plexon-dev3/AIR-QUALITY-PROJECTS/AIR QUALITY LEDS/AIR QUALITY LEDS.kicad_pcb

## KiCad design AIR QUALITY LEDS/AIR QUALITY LEDS.kicad_pcb (2026-05-13)

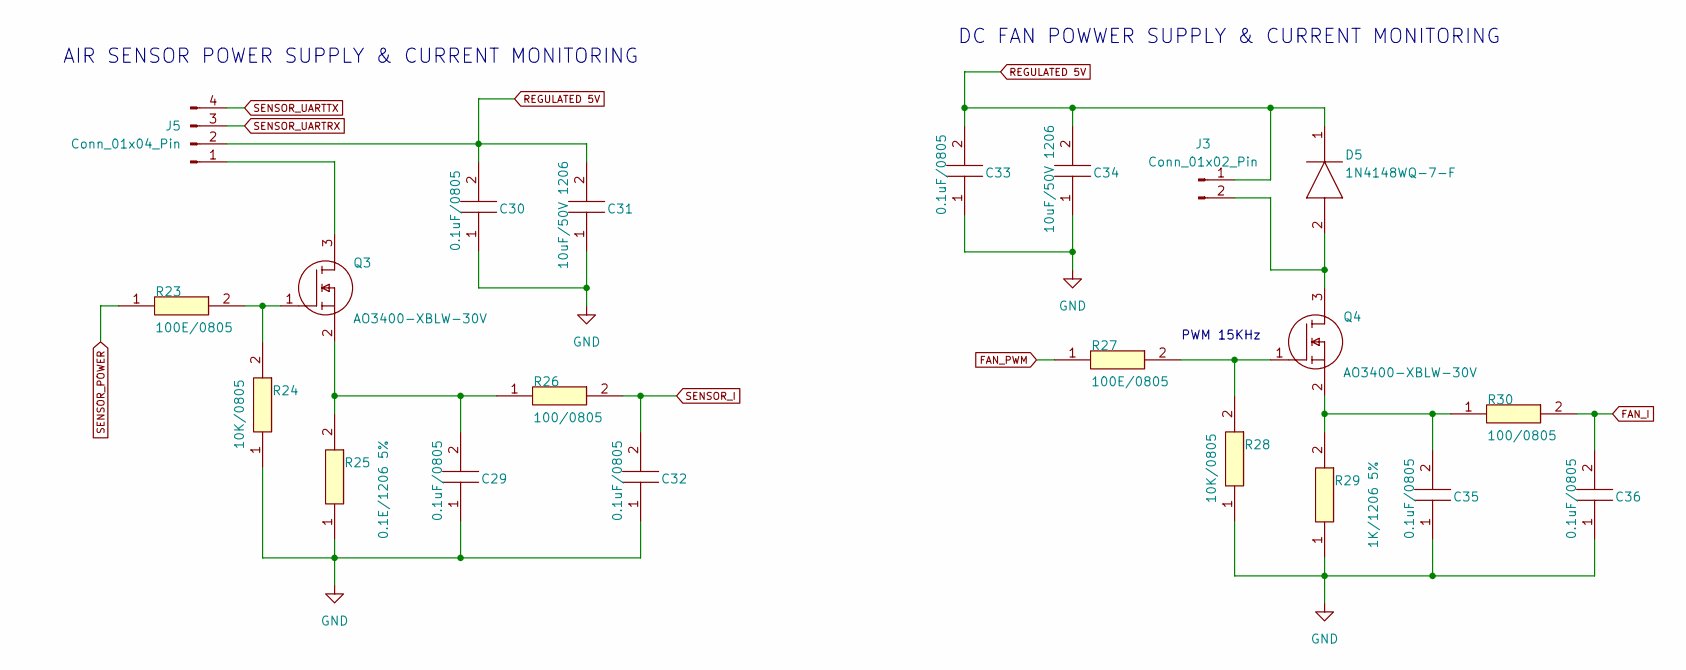
[picture p1: schematic SENSOR+FAN.kicad_sch]

Parts:
C29, C30, C32, C33, C35, C36: 0.1uF/0805; C_0805_2012Metric; MANUFACTURER_PART_NUMBER C0805C100F1GACAUTO
C31, C34: 10uF/50V 1206; C_1206_3216Metric; MANUFACTURER_PART_NUMBER C1206C221F5GACAUTO; MOUSER PART NUMBER 80-C1206C221F5GAUTO
D5: 1N4148WQ-7-F; SOD3716X145N; MANUFACTURER_PART_NUMBER 1N4148WQ-7-F; MOUSER PART NUMBER 621-1N4148WQ-7-F
J3: Conn_01x02_Pin; PinSocket_1x02_P2.54mm_Vertical
J5: Conn_01x04_Pin; Hirose_DF13-04P-1.25DSA_1x04_P1.25mm_Vertical
Q3, Q4: AO3400-XBLW-30V; SOT95P237X112-3N; MANUFACTURER_PART_NUMBER IRLML6344TRPBF; MOUSER PART NUMBER 942-IRLML6344TRPBF
R23, R27: 100E/0805; R_0805_2012Metric; MANUFACTURER_PART_NUMBER CMP0805QFX-1001ELF; MOUSER PART NUMBER 652-CMP0805QFX-1001E
R24, R28: 10K/0805; R_0805_2012Metric; MANUFACTURER_PART_NUMBER CMP0805QFX-1001ELF; MOUSER PART NUMBER 652-CMP0805QFX-1001E
R25: 0.1E/1206 5%; R_1206_3216Metric; MANUFACTURER_PART_NUMBER CR1206-FX-16R2ELF; MOUSER PART NUMBER 652-CR1206FX-16R2ELF
R26, R30: 100/0805; R_0805_2012Metric; MANUFACTURER_PART_NUMBER CMP0805QFX-1001ELF; MOUSER PART NUMBER 652-CMP0805QFX-1001E
R29: 1K/1206 5%; R_1206_3216Metric; MANUFACTURER_PART_NUMBER CR1206-FX-16R2ELF; MOUSER PART NUMBER 652-CR1206FX-16R2ELF

Connections:
FAN_I: C36.2, R30.2; also elsewhere on the board
FAN_PWM: R27.1; also elsewhere on the board
GND: C29.1, C30.1, C31.1, C32.1, C33.1, C34.1, C35.1, C36.1, R24.1, R25.1, R28.1, R29.1; also elsewhere on the board
unnamed: D5.2 (A), J3.2, Q4.3 (D)
unnamed: J5.1, Q3.3 (D)
unnamed: Q3.1 (G), R23.2, R24.2
unnamed: C29.2, Q3.2 (S), R25.2, R26.1
unnamed: Q4.1 (G), R27.2, R28.2
unnamed: C35.2, Q4.2 (S), R29.2, R30.1
REGULATED 5V: C30.2, C31.2, C33.2, C34.2, D5.1 (K), J3.1, J5.2; also elsewhere on the board
SENSOR_I: C32.2, R26.2; also elsewhere on the board
SENSOR_POWER: R23.1; also elsewhere on the board
SENSOR_UARTRX: J5.3; also elsewhere on the board
SENSOR_UARTTX: J5.4; also elsewhere on the board

Notes on the sheet:
AIR SENSOR POWER SUPPLY & CURRENT MONITORING
DC FAN POWWER SUPPLY & CURRENT MONITORING
PWM 15KHz

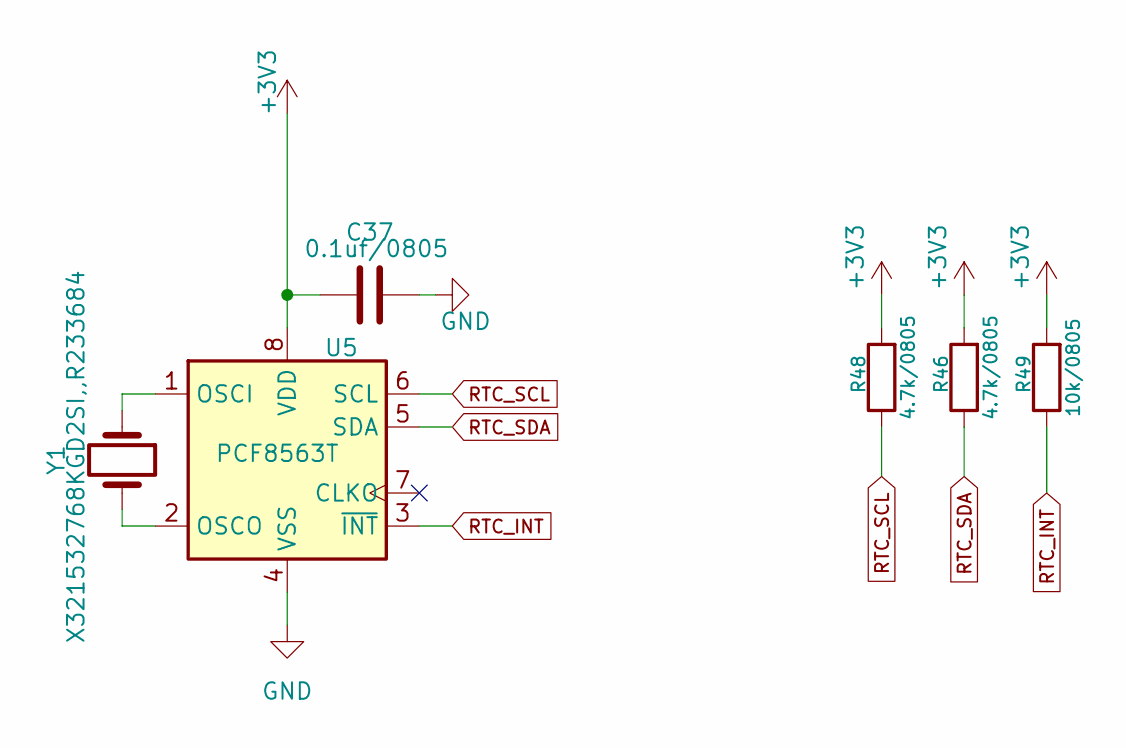
[picture p2: schematic RTC.kicad_sch]

Parts:
C37: 0.1uf/0805; C_0805_2012Metric
R46, R48: 4.7k/0805; R_0805_2012Metric
R49: 10k/0805; R_0805_2012Metric
U5: PCF8563T; SO-8_3.9x4.9mm_P1.27mm
Y1: X321532768KGD2SI,,R233684; Crystal_SMD_MicroCrystal_CC7V-T1A-2Pin_3.2x1.5mm

Connections:
+3V3: C37.1, R46.2, R48.2, R49.2, U5.8 (VDD); also elsewhere on the board
GND: C37.2, U5.4 (VSS); also elsewhere on the board
unnamed: U5.1 (OSCI), Y1.1
unnamed: U5.2 (OSCO), Y1.2
RTC_INT: R49.1, U5.3 (~INT); also elsewhere on the board
RTC_SCL: R48.1, U5.6 (SCL); also elsewhere on the board
RTC_SDA: R46.1, U5.5 (SDA); also elsewhere on the board

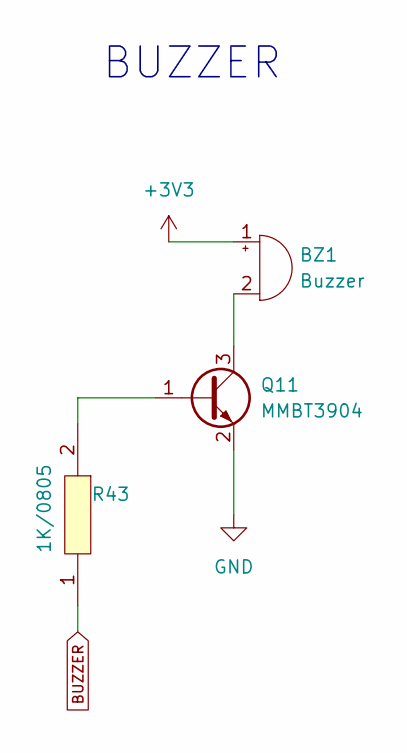
[picture p3: schematic BUZZER.kicad_sch]

Parts:
BZ1: Buzzer; Buzzer_12x9.5RM7.6
Q11: MMBT3904; SOT-23
R43: 1K/0805; R_0805_2012Metric; MANUFACTURER_PART_NUMBER CMP0805QFX-1001ELF; MOUSER PART NUMBER 652-CMP0805QFX-1001E

Connections:
+3V3: BZ1.1 (+); also elsewhere on the board
BUZZER: R43.1; also elsewhere on the board
GND: Q11.2 (E); also elsewhere on the board
unnamed: BZ1.2 (-), Q11.3 (C)
unnamed: Q11.1 (B), R43.2

Notes on the sheet:
BUZZER

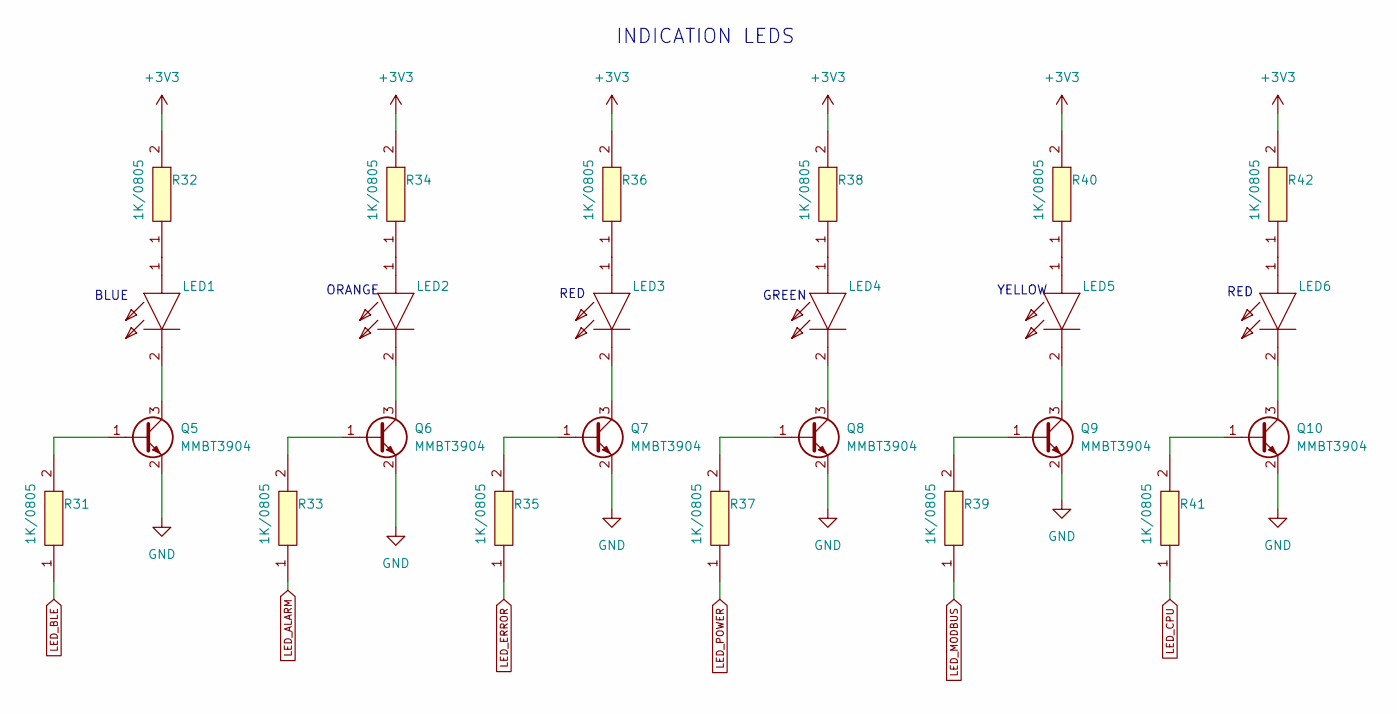
[picture p4: schematic INDICATION_LEDS.kicad_sch]

Parts:
LED1, LED2, LED3, LED4, LED5, LED6: LED_D5.0mm; MANUFACTURER_PART_NUMBER 151051BS04000; MOUSER PART NUMBER 710-151051BS04000
Q5, Q6, Q7, Q8, Q9, Q10: MMBT3904; SOT-23
R31, R32, R33, R34, R35, R36, R37, R38, R39, R40, R41, R42: 1K/0805; R_0805_2012Metric; MANUFACTURER_PART_NUMBER CMP0805QFX-1001ELF; MOUSER PART NUMBER 652-CMP0805QFX-1001E

Connections:
+3V3: R32.2, R34.2, R36.2, R38.2, R40.2, R42.2; also elsewhere on the board
GND: Q5.2 (E), Q6.2 (E), Q7.2 (E), Q8.2 (E), Q9.2 (E), Q10.2 (E); also elsewhere on the board
LED_ALARM: R33.1; also elsewhere on the board
LED_BLE: R31.1; also elsewhere on the board
LED_CPU: R41.1; also elsewhere on the board
LED_ERROR: R35.1; also elsewhere on the board
LED_MODBUS: R39.1; also elsewhere on the board
LED_POWER: R37.1; also elsewhere on the board
unnamed: LED1.1 (A), R32.1
unnamed: LED1.2 (K), Q5.3 (C)
unnamed: LED2.1 (A), R34.1
unnamed: LED2.2 (K), Q6.3 (C)
unnamed: LED3.1 (A), R36.1
unnamed: LED3.2 (K), Q7.3 (C)
unnamed: LED4.1 (A), R38.1
unnamed: LED4.2 (K), Q8.3 (C)
unnamed: LED5.1 (A), R40.1
unnamed: LED5.2 (K), Q9.3 (C)
unnamed: LED6.1 (A), R42.1
unnamed: LED6.2 (K), Q10.3 (C)
unnamed: Q5.1 (B), R31.2
unnamed: Q6.1 (B), R33.2
unnamed: Q7.1 (B), R35.2
unnamed: Q8.1 (B), R37.2
unnamed: Q9.1 (B), R39.2
unnamed: Q10.1 (B), R41.2

Notes on the sheet:
BLUE
RED
ORANGE
YELLOW
GREEN
INDICATION LEDS

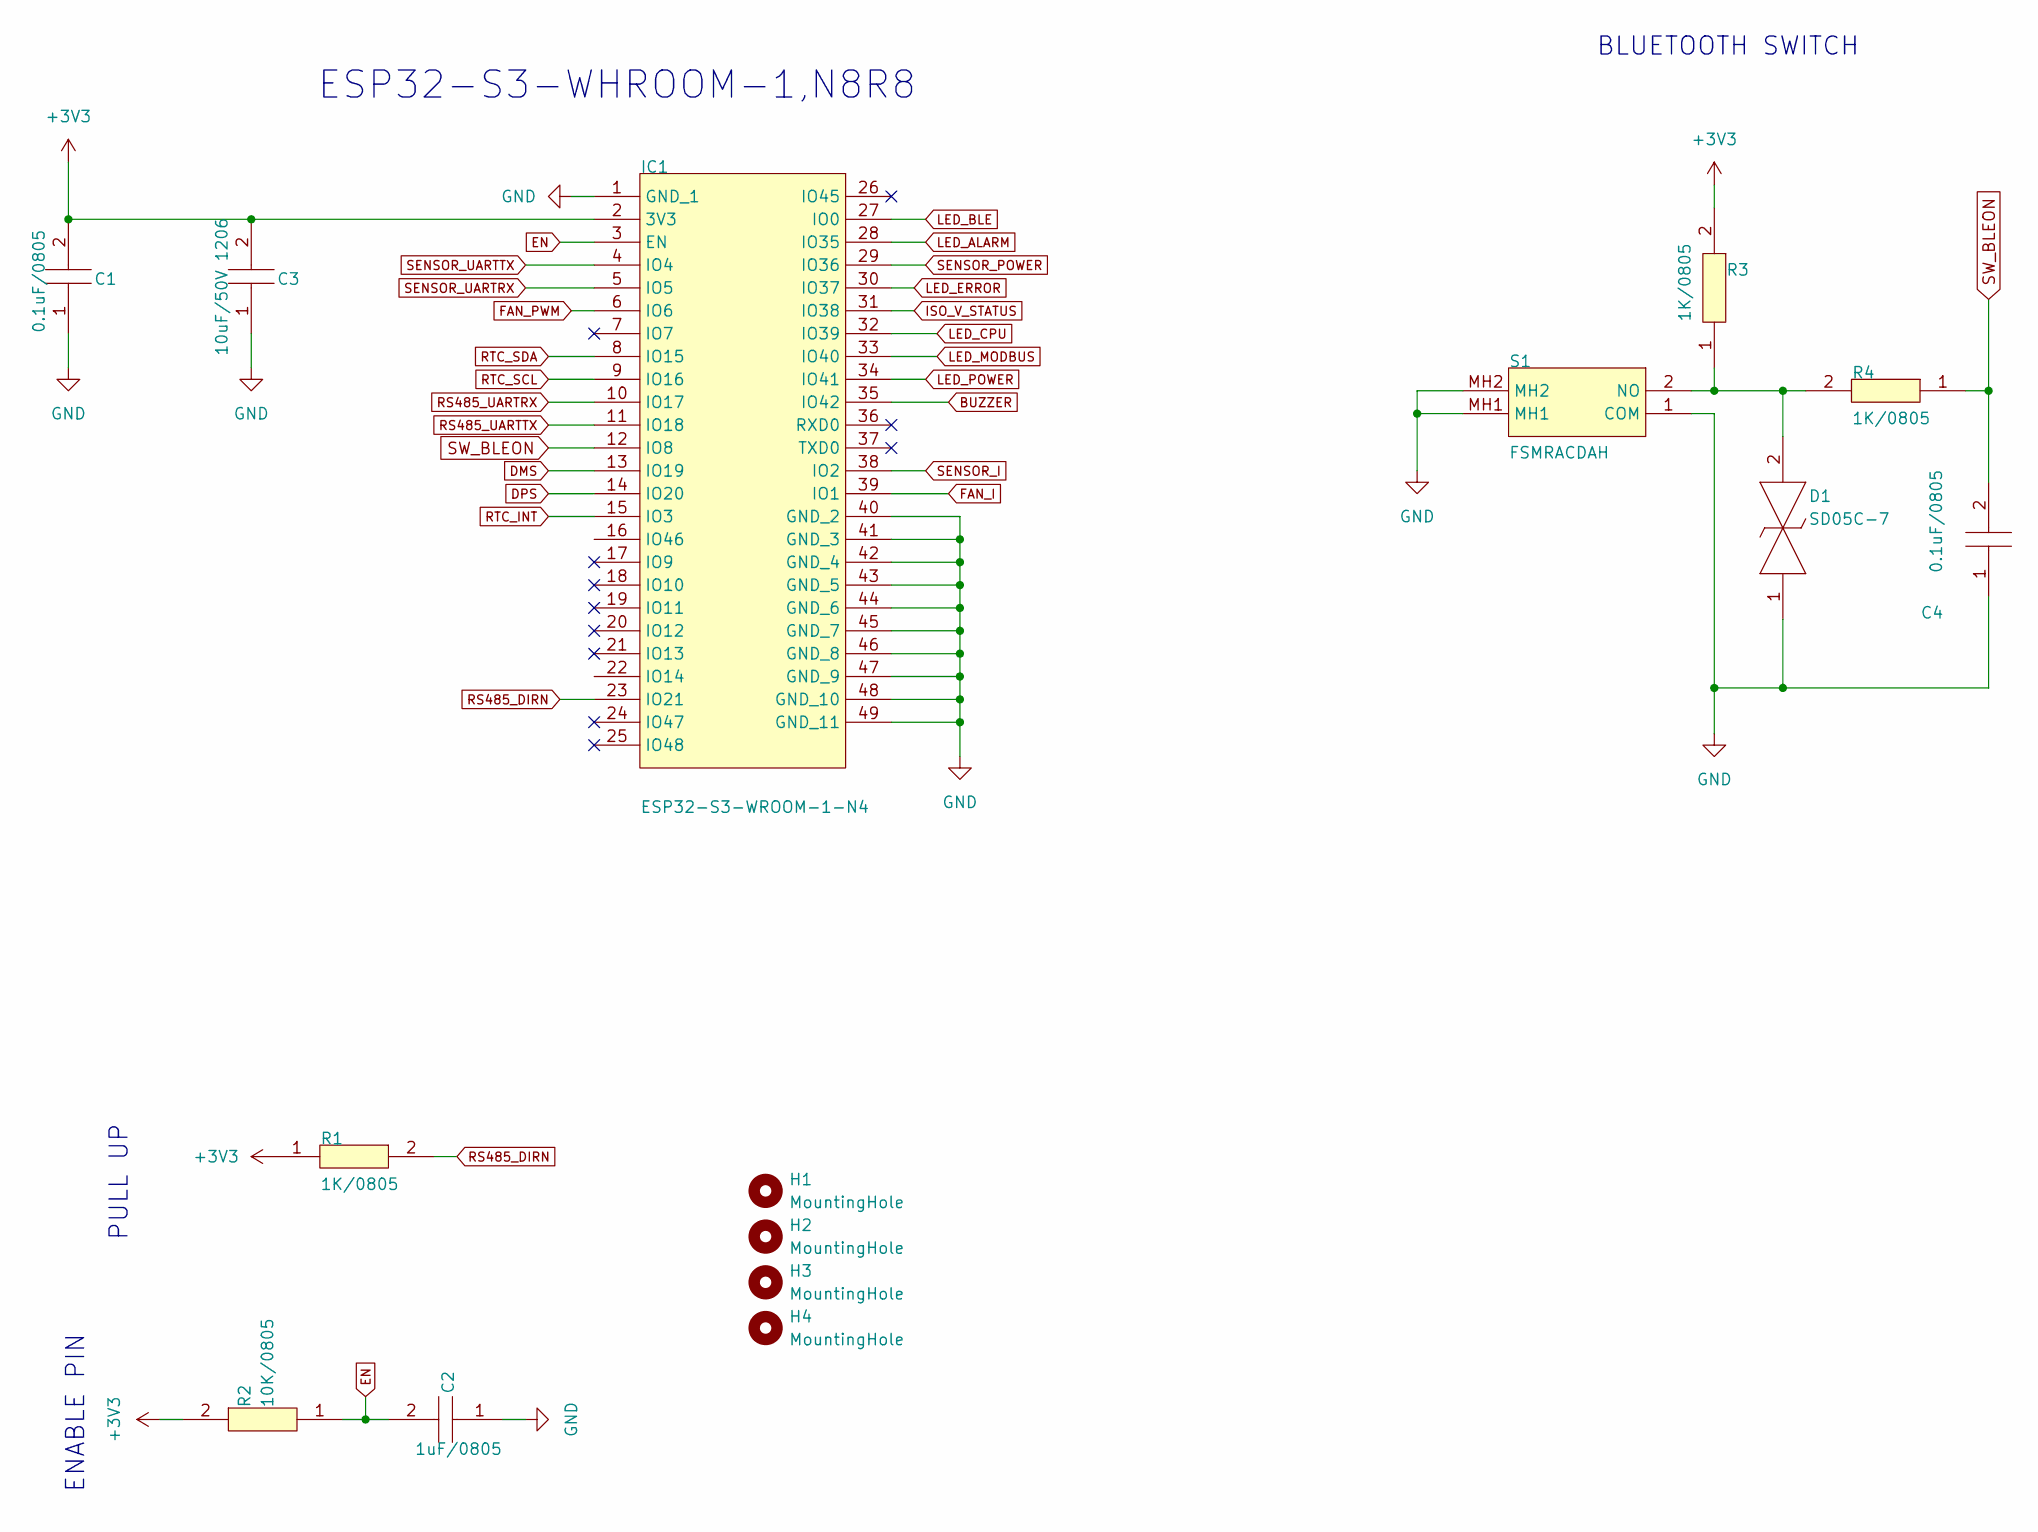
[picture p5: schematic ESP32-S3 MODULE.kicad_sch]

Parts:
C1, C4: 0.1uF/0805; C_0805_2012Metric; MANUFACTURER_PART_NUMBER C0805C100F1GACAUTO
C2: 1uF/0805; C_0805_2012Metric; MANUFACTURER_PART_NUMBER C0805C100F1GACAUTO
C3: 10uF/50V 1206; C_1206_3216Metric; MANUFACTURER_PART_NUMBER C1206C221F5GACAUTO; MOUSER PART NUMBER 80-C1206C221F5GAUTO
D1: SD05C-7; SOD2513X120N; MANUFACTURER_PART_NUMBER SD05C-7; MOUSER PART NUMBER 621-SD05C-7
H1, H2, H3, H4: MountingHole; MountingHole_3mm
IC1: ESP32-S3-WROOM-1-N4; ESP32S3WROOM1N8R8; MANUFACTURER_PART_NUMBER ESP32-S3-WROOM-1-N4; MOUSER PART NUMBER 356-ESP32-S3WROOM1N4
R1, R3, R4: 1K/0805; R_0805_2012Metric; MANUFACTURER_PART_NUMBER CMP0805QFX-1001ELF; MOUSER PART NUMBER 652-CMP0805QFX-1001E
R2: 10K/0805; R_0805_2012Metric; MANUFACTURER_PART_NUMBER CMP0805QFX-1001ELF; MOUSER PART NUMBER 652-CMP0805QFX-1001E
S1: FSMRACDAH; MANUFACTURER_PART_NUMBER FSMRACDAH; MOUSER PART NUMBER 506-FSMRACDAH

Connections:
+3V3: C1.2, C3.2, IC1.2 (3V3), R1.1, R2.2, R3.2; also elsewhere on the board
BUZZER: IC1.35 (IO42); also elsewhere on the board
DMS: IC1.13 (IO19); also elsewhere on the board
DPS: IC1.14 (IO20); also elsewhere on the board
EN: C2.2, IC1.3 (EN), R2.1
FAN_I: IC1.39 (IO1); also elsewhere on the board
FAN_PWM: IC1.6 (IO6); also elsewhere on the board
GND: C1.1, C2.1, C3.1, C4.1, D1.1, IC1.1 (GND_1), IC1.40 (GND_2), IC1.41 (GND_3), IC1.42 (GND_4), IC1.43 (GND_5), IC1.44 (GND_6), IC1.45 (GND_7), IC1.46 (GND_8), IC1.47 (GND_9), IC1.48 (GND_10), IC1.49 (GND_11), S1.1 (COM), S1.MH1, S1.MH2; also elsewhere on the board
ISO_V_STATUS: IC1.31 (IO38); also elsewhere on the board
LED_ALARM: IC1.28 (IO35); also elsewhere on the board
LED_BLE: IC1.27 (IO0); also elsewhere on the board
LED_CPU: IC1.32 (IO39); also elsewhere on the board
LED_ERROR: IC1.30 (IO37); also elsewhere on the board
LED_MODBUS: IC1.33 (IO40); also elsewhere on the board
LED_POWER: IC1.34 (IO41); also elsewhere on the board
unnamed: D1.2, R3.1, R4.2, S1.2 (NO)
RS485_DIRN: IC1.23 (IO21), R1.2; also elsewhere on the board
RS485_UARTRX: IC1.10 (IO17); also elsewhere on the board
RS485_UARTTX: IC1.11 (IO18); also elsewhere on the board
RTC_INT: IC1.15 (IO3); also elsewhere on the board
RTC_SCL: IC1.9 (IO16); also elsewhere on the board
RTC_SDA: IC1.8 (IO15); also elsewhere on the board
SENSOR_I: IC1.38 (IO2); also elsewhere on the board
SENSOR_POWER: IC1.29 (IO36); also elsewhere on the board
SENSOR_UARTRX: IC1.5 (IO5); also elsewhere on the board
SENSOR_UARTTX: IC1.4 (IO4); also elsewhere on the board
SW_BLEON: C4.2, IC1.12 (IO8), R4.1

Notes on the sheet:
PULL UP
BLUETOOTH SWITCH
ENABLE PIN
ESP32-S3-WHROOM-1,N8R8

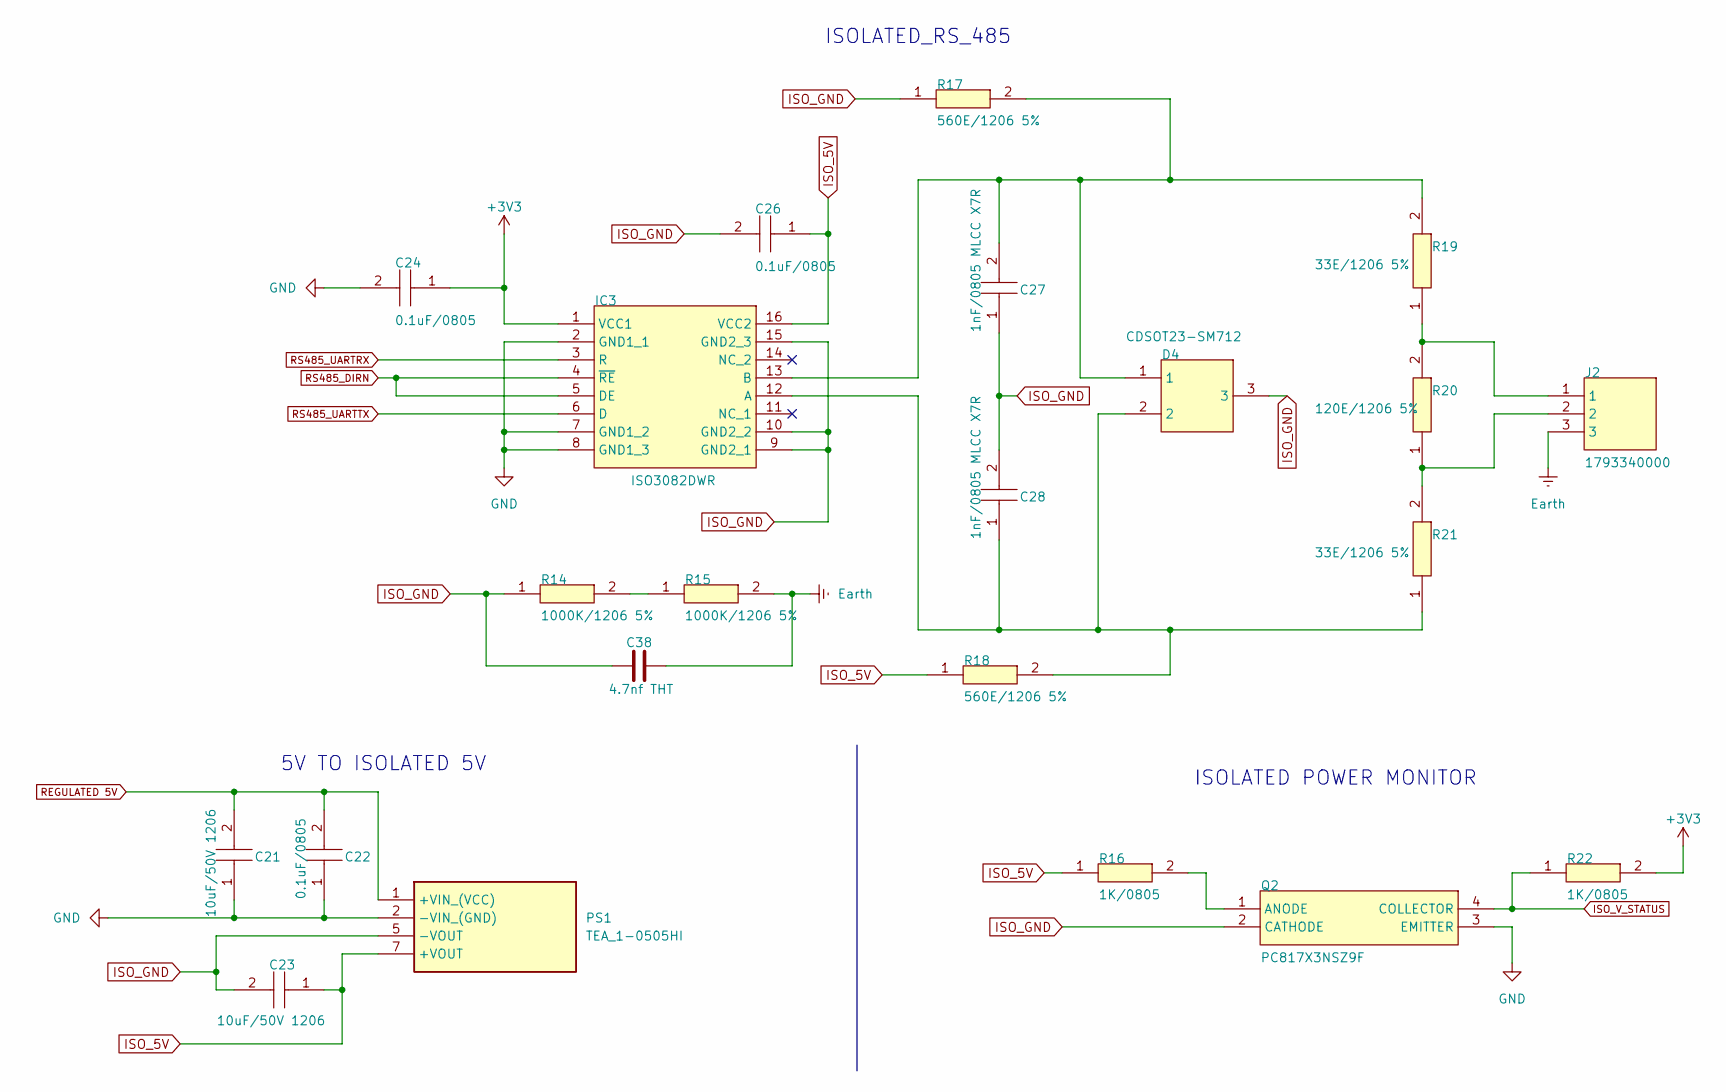
[picture p6: schematic ISOLATED_RS485.kicad_sch]

Parts:
C21, C23: 10uF/50V 1206; C_1206_3216Metric; MANUFACTURER_PART_NUMBER C1206C221F5GACAUTO; MOUSER PART NUMBER 80-C1206C221F5GAUTO
C22, C24, C26: 0.1uF/0805; C_0805_2012Metric; MANUFACTURER_PART_NUMBER C0805C100F1GACAUTO
C27, C28: 1nF/0805 MLCC X7R; C_0805_2012Metric; MANUFACTURER_PART_NUMBER C0805C100F1GACAUTO
C38: 4.7nf THT; C_Disc_D3.0mm_W1.6mm_P2.50mm
D4: CDSOT23-SM712; SOT95P230X117-3N; MANUFACTURER_PART_NUMBER CDSOT23-SM712; MOUSER PART NUMBER 652-CDSOT23-SM712
IC3: ISO3082DWR; SOIC127P1030X265-16N; MANUFACTURER_PART_NUMBER ISO3082DWR; MOUSER PART NUMBER 595-ISO3082DWR
J2: 1793340000; MANUFACTURER_PART_NUMBER 1793340000; MOUSER PART NUMBER 470-1793340000
PS1: TEA_1-0505HI; TEA10505HI; Mouser Part Number 495-TEA1-0505HI
Q2: PC817X3NSZ9F; DIP762W60P254L460H450Q4N; MANUFACTURER_PART_NUMBER PC817X3NSZ9F; MOUSER PART NUMBER 852-PC817X3NSZ9F
R14, R15: 1000K/1206 5%; R_1206_3216Metric; MANUFACTURER_PART_NUMBER CR1206-FX-16R2ELF; MOUSER PART NUMBER 652-CR1206FX-16R2ELF
R16, R22: 1K/0805; R_0805_2012Metric; MANUFACTURER_PART_NUMBER CMP0805QFX-1001ELF; MOUSER PART NUMBER 652-CMP0805QFX-1001E
R17, R18: 560E/1206 5%; R_1206_3216Metric; MANUFACTURER_PART_NUMBER CR1206-FX-16R2ELF; MOUSER PART NUMBER 652-CR1206FX-16R2ELF
R19, R21: 33E/1206 5%; R_1206_3216Metric; MANUFACTURER_PART_NUMBER CR1206-FX-16R2ELF; MOUSER PART NUMBER 652-CR1206FX-16R2ELF
R20: 120E/1206 5%; R_1206_3216Metric; MANUFACTURER_PART_NUMBER CR1206-FX-16R2ELF; MOUSER PART NUMBER 652-CR1206FX-16R2ELF

Connections:
+3V3: C24.1, IC3.1 (VCC1), R22.2; also elsewhere on the board
Earth: C38.2, J2.3, R15.2
GND: C21.1, C22.1, C24.2, IC3.2 (GND1_1), IC3.7 (GND1_2), IC3.8 (GND1_3), PS1.2 (-VIN_(GND)), Q2.3 (EMITTER); also elsewhere on the board
ISO_5V: C23.1, C26.1, IC3.16 (VCC2), PS1.7 (+VOUT), R16.1, R18.1
ISO_GND: C23.2, C26.2, C27.1, C28.2, C38.1, D4.3, IC3.9 (GND2_1), IC3.10 (GND2_2), IC3.15 (GND2_3), PS1.5 (-VOUT), Q2.2 (CATHODE), R14.1, R17.1
ISO_V_STATUS: Q2.4 (COLLECTOR), R22.1; also elsewhere on the board
unnamed: C28.1, D4.2, IC3.12 (A), R18.2, R21.1
unnamed: C27.2, D4.1, IC3.13 (B), R17.2, R19.2
unnamed: J2.1, R19.1, R20.2
unnamed: J2.2, R20.1, R21.2
unnamed: Q2.1 (ANODE), R16.2
unnamed: R14.2, R15.1
REGULATED 5V: C21.2, C22.2, PS1.1 (+VIN_(VCC)); also elsewhere on the board
RS485_DIRN: IC3.4 (~RE), IC3.5 (DE); also elsewhere on the board
RS485_UARTRX: IC3.3 (R); also elsewhere on the board
RS485_UARTTX: IC3.6 (D); also elsewhere on the board

Notes on the sheet:
5V TO ISOLATED 5V
ISOLATED_RS_485
ISOLATED POWER MONITOR

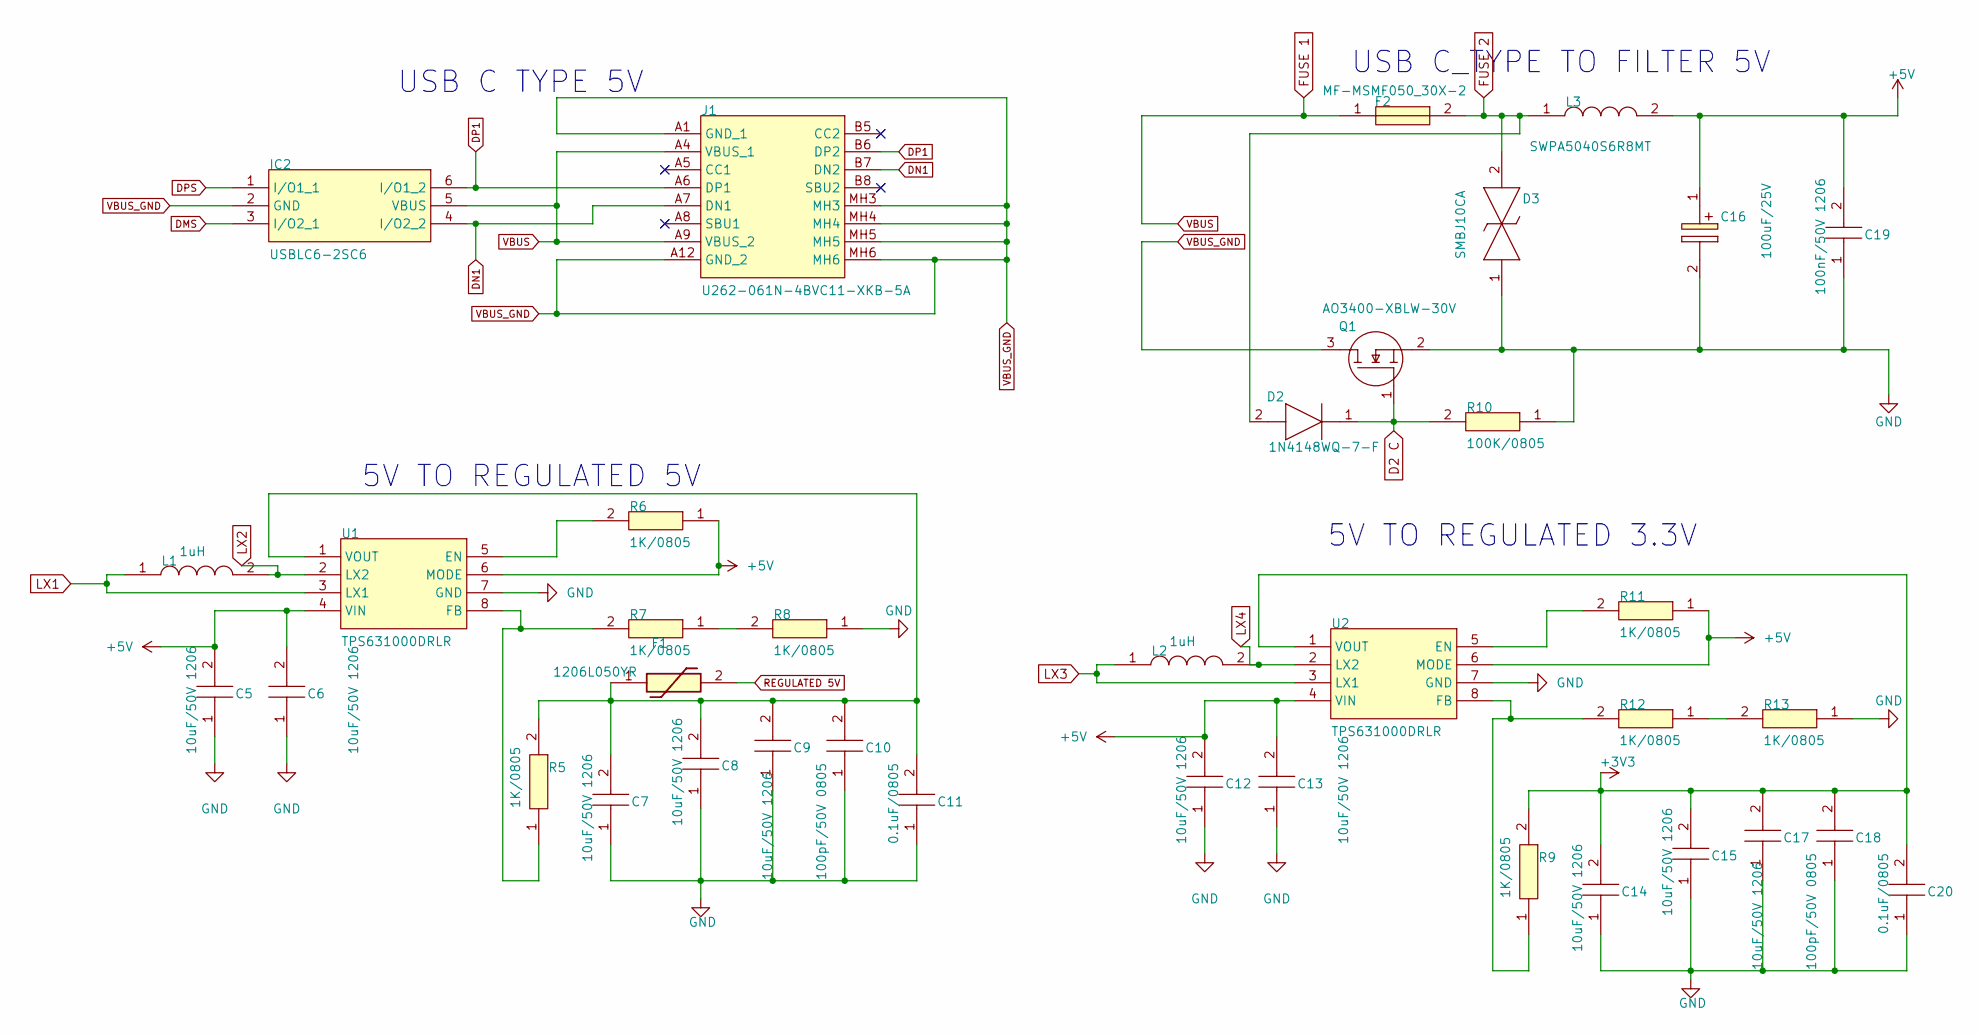
[picture p7: schematic POWER SUPPLY.kicad_sch]

Parts:
C5, C6, C7, C8, C9, C12, C13, C14, C15, C17: 10uF/50V 1206; C_1206_3216Metric; MANUFACTURER_PART_NUMBER C1206C221F5GACAUTO; MOUSER PART NUMBER 80-C1206C221F5GAUTO
C10, C18: 100pF/50V 0805; C_0805_2012Metric; MANUFACTURER_PART_NUMBER C0805C100F1GACAUTO
C11, C20: 0.1uF/0805; C_0805_2012Metric; MANUFACTURER_PART_NUMBER C0805C100F1GACAUTO
C16: 100uF/25V; CAPPRD200W50D500H1250; MANUFACTURER_PART_NUMBER ESK106M035AC3AA; MOUSER PART NUMBER 80-ESK106M035AC3AA
C19: 100nF/50V 1206; C_1206_3216Metric; MANUFACTURER_PART_NUMBER C1206C221F5GACAUTO; MOUSER PART NUMBER 80-C1206C221F5GAUTO
D2: 1N4148WQ-7-F; SOD3716X145N; MANUFACTURER_PART_NUMBER 1N4148WQ-7-F; MOUSER PART NUMBER 621-1N4148WQ-7-F
D3: SMBJ10CA; DIONM5436X261N; MANUFACTURER_PART_NUMBER SMBJ28CA; MOUSER PART NUMBER 576-SMBJ28CA
F1: 1206L050YR; 1206L05015YR; Mouser Part Number 576-1206L050YR
F2: MF-MSMF050_30X-2; FUSC4632X85N; MANUFACTURER_PART_NUMBER MF-MSMF050/30X-2; MOUSER PART NUMBER 652-MF-MSMF050/30X-2
IC2: USBLC6-2SC6; SOT95P280X145-6N; MANUFACTURER_PART_NUMBER USBLC6-2SC6; MOUSER PART NUMBER 511-USBLC6-2SC6
J1: U262-061N-4BVC11-XKB-5A; USB480003A; MANUFACTURER_PART_NUMBER USB4800-03-A; MOUSER PART NUMBER 640-USB4800-03-A
L1, L2: 1uH; DFE2HCAH1R0MJ0L; MANUFACTURER_PART_NUMBER DFE252012P-1R0M=P2; MOUSER PART NUMBER 81-DFE252012P-1R0MP2
L3: SWPA5040S6R8MT; 74404054330; MANUFACTURER_PART_NUMBER 74404054330; MOUSER PART NUMBER 710-74404054330
Q1: AO3400-XBLW-30V; SOT95P237X112-3N; MANUFACTURER_PART_NUMBER IRLML6344TRPBF; MOUSER PART NUMBER 942-IRLML6344TRPBF
R5, R6, R7, R8, R9, R11, R12, R13: 1K/0805; R_0805_2012Metric; MANUFACTURER_PART_NUMBER CMP0805QFX-1001ELF; MOUSER PART NUMBER 652-CMP0805QFX-1001E
R10: 100K/0805; R_0805_2012Metric; MANUFACTURER_PART_NUMBER CMP0805QFX-1001ELF; MOUSER PART NUMBER 652-CMP0805QFX-1001E
U1, U2: TPS631000DRLR; SOTFL50P160X60-8N; MANUFACTURER_PART_NUMBER TPS631000DRLR; MOUSER PART NUMBER 595-TPS631000DRLR

Connections:
+3V3: C14.2, C15.2, C17.2, C18.2, C20.2, R9.2, U2.1 (VOUT); also elsewhere on the board
+5V: C5.2, C6.2, C12.2, C13.2, C16.1 (+), C19.2, L3.2, R6.1, R11.1, U1.4 (VIN), U1.6 (MODE), U2.4 (VIN), U2.6 (MODE)
D2 C: D2.1 (K), Q1.1 (G), R10.2
DMS: IC2.3 (I/O2_1); also elsewhere on the board
DN1: IC2.4 (I/O2_2), J1.A7 (DN1), J1.B7 (DN2)
DP1: IC2.6 (I/O1_2), J1.A6 (DP1), J1.B6 (DP2)
DPS: IC2.1 (I/O1_1); also elsewhere on the board
FUSE 1: F2.1, IC2.5 (VBUS), J1.A4 (VBUS_1), J1.A9 (VBUS_2)
FUSE 2: D2.2 (A), D3.2, F2.2, L3.1
GND: C5.1, C6.1, C7.1, C8.1, C9.1, C10.1, C11.1, C12.1, C13.1, C14.1, C15.1, C16.2 (-), C17.1, C18.1, C19.1, C20.1, D3.1, Q1.2 (S), R8.1, R10.1, R13.1, U1.7 (GND), U2.7 (GND); also elsewhere on the board
LX1: L1.1, U1.3 (LX1)
LX2: L1.2, U1.2 (LX2)
LX3: L2.1, U2.3 (LX1)
LX4: L2.2, U2.2 (LX2)
unnamed: R7.1, R8.2
unnamed: R12.1, R13.2
unnamed: R6.2, U1.5 (EN)
unnamed: R5.1, R7.2, U1.8 (FB)
unnamed: C7.2, C8.2, C9.2, C10.2, C11.2, F1.1, R5.2, U1.1 (VOUT)
unnamed: R11.2, U2.5 (EN)
unnamed: R9.1, R12.2, U2.8 (FB)
REGULATED 5V: F1.2; also elsewhere on the board
VBUS_GND: IC2.2 (GND), J1.A1 (GND_1), J1.A12 (GND_2), J1.MH3, J1.MH4, J1.MH5, J1.MH6, Q1.3 (D)

Notes on the sheet:
5V TO REGULATED 5V
USB C_TYPE TO FILTER 5V
5V TO REGULATED 3.3V
USB C TYPE 5V

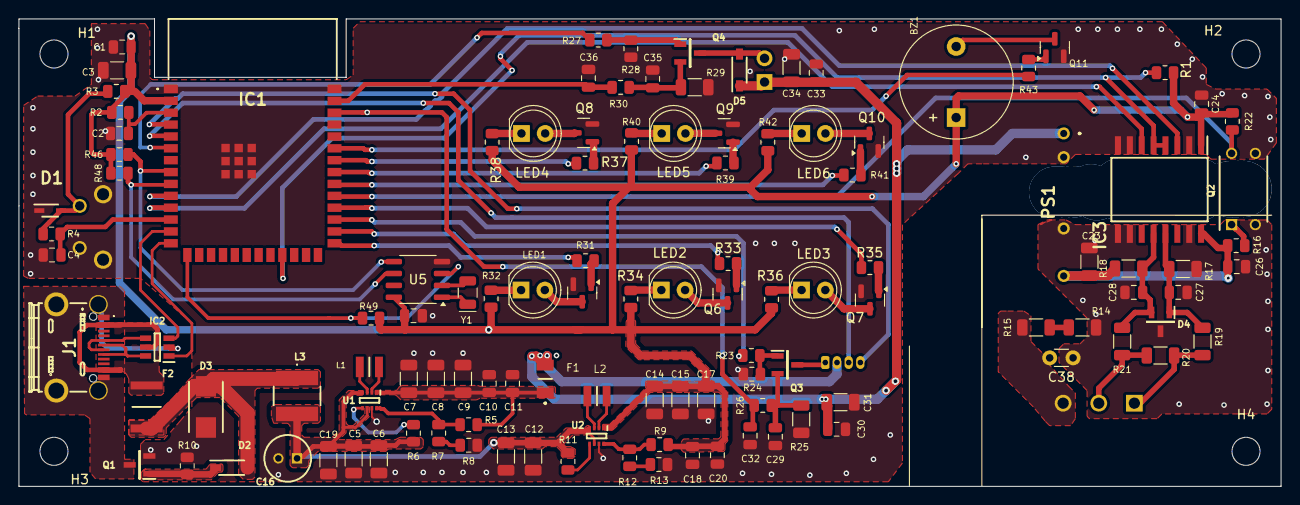
[picture p8: board AIR QUALITY LEDS.kicad_pcb from above]

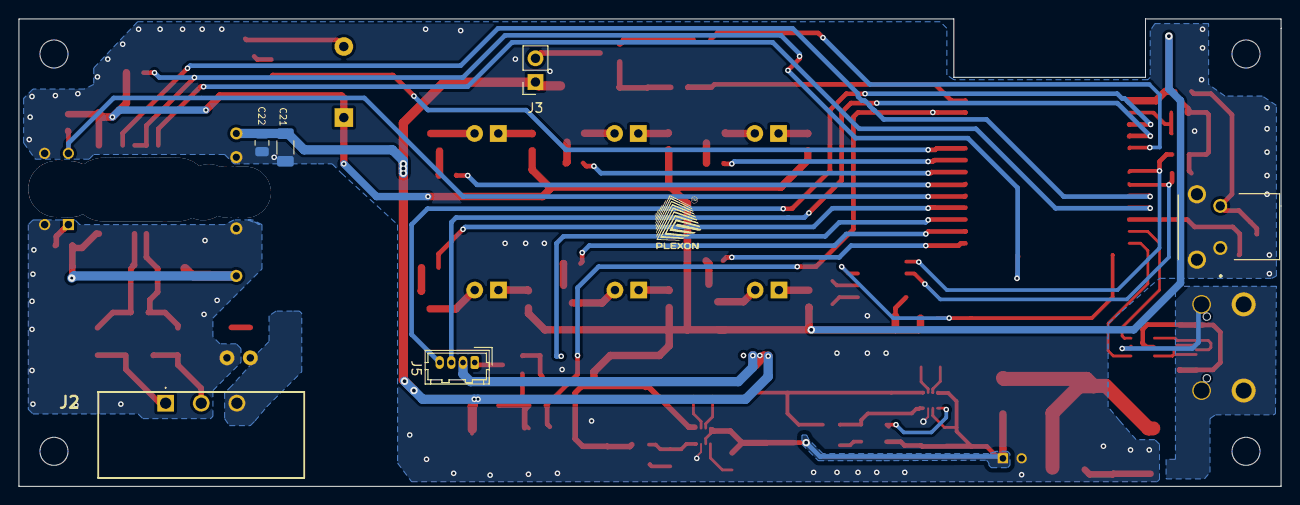
[picture p9: board AIR QUALITY LEDS.kicad_pcb from below]

Board: 2 copper layers, 135.0 x 50.0 mm, 128 parts (6 on the bottom side), 83 nets.
